monbera/M0Rx/3d/Deckel.stl

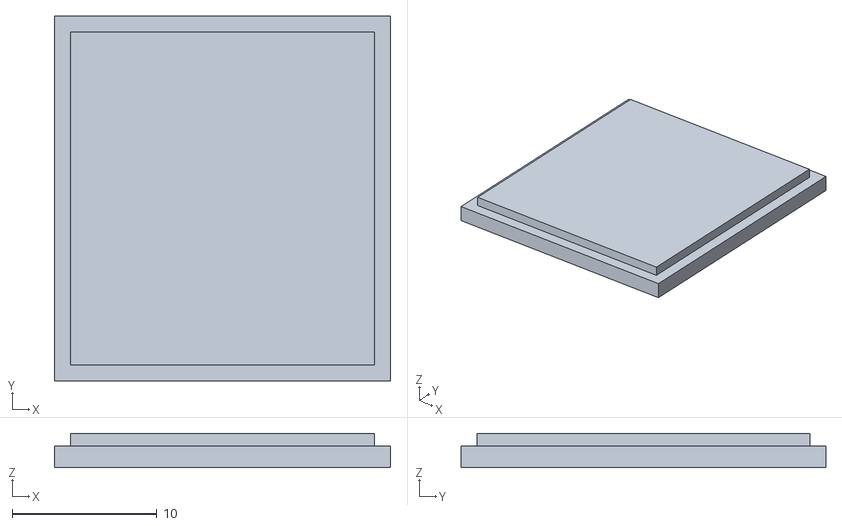
[picture p3: CAD file, 2020-05-06]
3d/Deckel.stl
23.2 x 25.2 x 2.38
