monbera/M0Rx/3d/Gehauese.stl

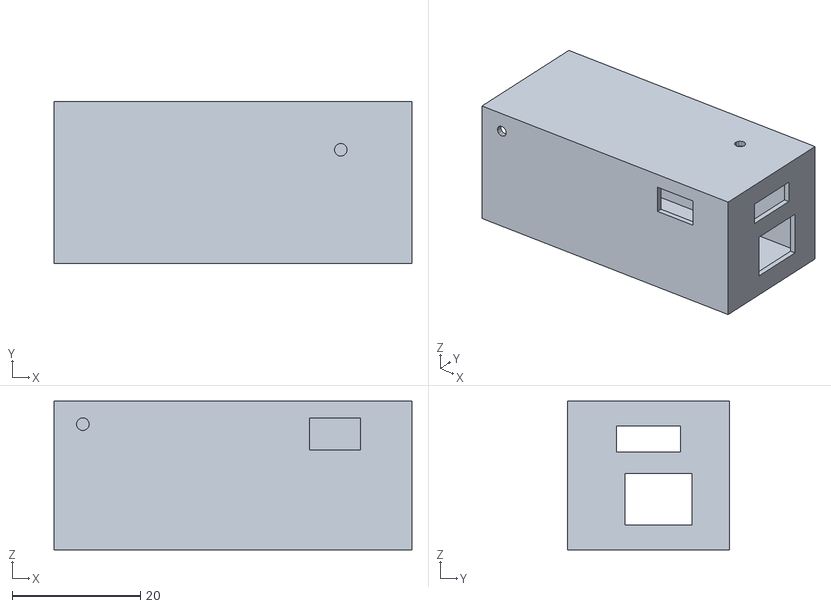
[picture p4: CAD file, 2020-05-06]
3d/Gehauese.stl
55.8 x 25.2 x 23.2
