monbera/M0Rx/3d/Deckel.scad

$fa = 0.2;
$fs = 0.2;
rotate([0,-90,0]){
cube ([1.5, 25.2, 23.2], center = true);   
translate([+1,0,0])
cube ([1.25, 23, 21], center = true);  
}
