monbera/M0Rx/(commit log)

2020-05-06 Error trimming and impulse calculation fixed. 3d model added.
    [M0Rx.ino, cfg.h]
2020-05-06 3d model added.
    [Deckel.stl, Gehauese.stl]
2021-02-07 M0Rx ----------------------------------------------------------- M0Rx.ino - FStimeout changed from 1000 to 2000 ms - first delay before while (status != WL_CONNECTED) removed - increasing of delay be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
    cfg.h
    - configuration for MyCar1 added
    3d
    - scad file added
    [Deckel.scad, Gehauese.scad]
